jiqin7/ESP32-AI-Touch-Doll/README.md

# 共感娃娃超保姆级教程（整理版）

本教程主要说明：如何连接 ESP32 与 FSR402 压力传感器、用 Arduino IDE 烧录并进行联通测试、让 ESP32 连接 WiFi 并把数据传给电脑，以及在手机端用 Termux 和 Operit「触觉桥」读取触觉事件。建议按章节顺序操作；遇到问题先查第 7 节“常见问题速查”。

> *声明：以上教程为我@无限欧气 根据小红书@Eve分享的文件制作经验总结，旧版 ESP32烧录代码参考了@Eve老师的框架和思路。*

## 目录
- [材料清单](#材料清单)
- [0. 注意事项（务必先读）](#0-注意事项务必先读)
- [1. 实践心得与准备](#1-实践心得与准备)
- [2. 传感器连接](#2-传感器连接)
- [3. Arduino IDE：基础与联通测试](#3-arduino-ide基础与联通测试)
- [4. 电脑端：网络连接与 Python 服务](#4-电脑端网络连接与-python-服务)
- [5. 传感器参数调整指南](#5-传感器参数调整指南)
- [6. 手机端：v5 固件直连（推荐，免 Python）](#6-手机端v5-固件直连推荐免-python)
- [6A. 旧版：Termux 及 Operit 触觉桥（备选）](#6a-旧版termux-及-operit-触觉桥备选)
- [7. 常见问题速查](#7-常见问题速查)
- [8. 收尾工作（快问快答）](#8-收尾工作快问快答)
- [制作感言](#制作感言)

---

## 材料清单

- **ESP32-S3-N16R8（排针已焊接）开发板** *1
- **400孔面包板** *1
- **10kΩ 电阻** *10（几个传感器需几个）
- **FSR402传感器**（范围较小，适合小玩偶）或 **FSR406传感器**（范围较大，适合大玩偶）（建议上💩sz发货的）
- **电工胶带** *1
- **20cm 公对公杜邦线**：用于跳线。（x传感器x根跳线）
- **20㎝及以上 公对母杜邦线**：用于连接开发板、传感器、面包板。（传感器数量×4，还需要备用一些，用于加长）
- **隐形拉链**（非必需，小玩偶大多无拉链，有需要的可以买）
- **玩偶**（至少35cm）
- **针线/点状魔术贴**（固定传感器，具体用什么方法视玩偶本身毛长而定。）
- **18650充放电模块** *1（用于开发板供电，非必需。800mAh续航约3.5小时）

---

## 0. 注意事项（务必先读）

为保证不失误导致硬件损坏，请务必认真看完再尝试。

1. **接线前仔细核对**：不要接错正负极；不要用 5V 电源（充电宝、电池盒的 5V）去接 3V3 引脚，板子会烧。
2. **通电状态下防短路**：杜邦线裸露的金属针头绝不能互相碰触，也别碰到板子背面的金属焊点。**接线、拔线前必须先拔掉电源。**
3. **棉絮引发死机**：绝对不要把裸露的电路板直接埋进棉花里。棉絮钻进 Type-C 口或排针孔会导致短路。电路板必须装进塑料袋或用绝缘胶布包裹后，才能塞入玩偶。
4. **暴力插拔会扯断焊盘**：拔杜邦线时一定要捏住黑色塑料头拔，绝对不能拽着软线硬拉。排针被连根拔起（焊盘脱落），没有电烙铁就彻底报废了。
5. **传感器引脚折断不可逆**：FSR402 薄膜传感器的引脚是碳膜印制，一折就断，无法修复。请务必用胶带把延长线的接头死死缠住；回填棉花时绝不能把线绷得太紧。

---

## 1. 实践心得与准备

1. 杜邦线黑色接头有一侧会露出金属。两根杜邦线对接时，露出金属的一面保持同向，连接更稳；接 ESP32 引脚时缺口朝外，接 FSR402 传感器时金属面朝上，都会更牢固。
2. 杜邦线对接处、传感器引脚位置，都要用胶带缠紧固定，防止松动、断线。
3. 建议用硬纸板做一块和传感器尺寸相近的厚垫板来固定传感器，避免棉花承受压力。
4. 记住：**接线时不要通电；重新烧录后记得复位（RST）。**
5. 烧录一定得是**数据线**。

> 仅个人经验分享，硬件操作风险自担。

---

## 2. 传感器连接

### 2.1 总原则

每一个传感器至少需要连五根线：
- 传感器—面包板：①左 供电；②右 信号
- ESP32—面包板：①电源；②信号；③接地桩

先拿一条杜邦线，一头连面包板左上角红色 `+` 号第一格（下称 `+1/+2...`），一头连 ESP32 的 `3V3`。

> 接线、拔线前必须先断电。接完每个阶段建议先做联通测试。如果你够熟练，也可直接连四个，烧录最终代码。

### 2.2 接线表与示意图

| 传感器 | 传感器—面包板 | 面包板—电阻 | ESP32—面包板：电源 | ESP32—面包板：信号 | ESP32—面包板：接地 |
| :--- | :--- | :--- | :--- | :--- | :--- |
| 传感器1 | 左供电 `a5`；右信号 `a7` | `c7 --- c11` | 红 `+2 --- d5` | `g4 --- d7` | `g15 --- d11` |
| 传感器2 | 左供电 `a12`；右信号 `a14` | `c14 --- c16` | 红 `+3 --- d12` | `g5 --- d14` | `g18 --- d16` |
| 传感器3 | 左供电 `a19`；右信号 `a21` | `c24 --- c21` | 红 `+4 --- d19` | `g6 --- d21` | `g17 --- d24` |
| 传感器4 | 左供电 `a26`；右信号 `a28` | `c28 --- c30` | 红 `+5 --- d26` | `g7 --- d28` | `g16 --- d30` |

> 💡 **强烈建议直接看下面这张“合体版”连线图**，跟着图中的颜色和标注点插线，最不容易出错：

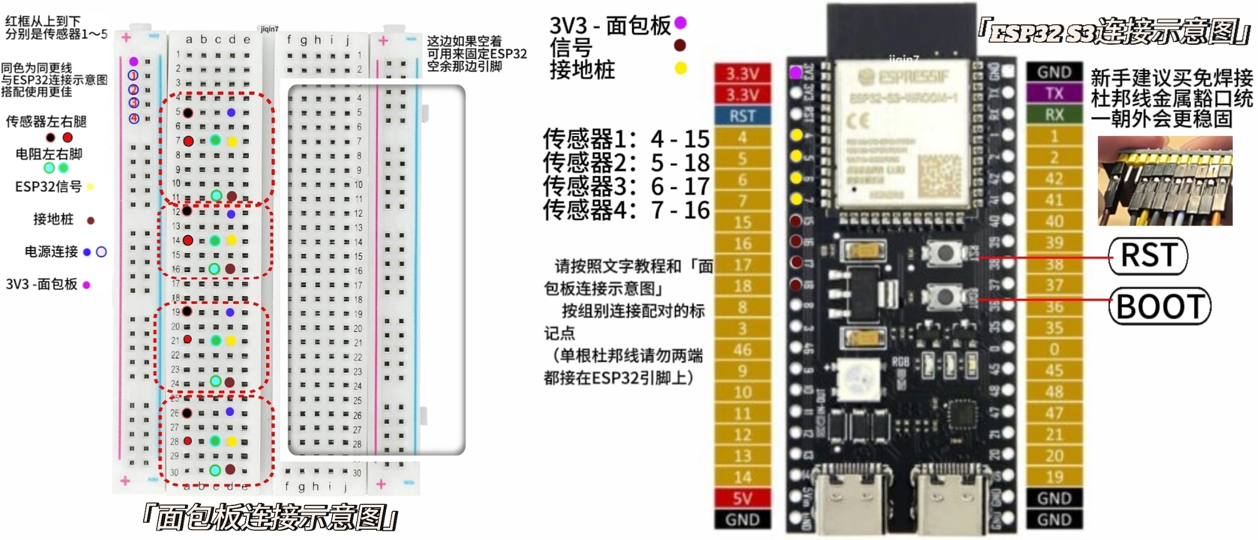
[picture p1: images/combined_wiring.jpg]
面包板与ESP32合体连线图


*(如果你的显示器够大，也可以参考下方分开的高清大图)*

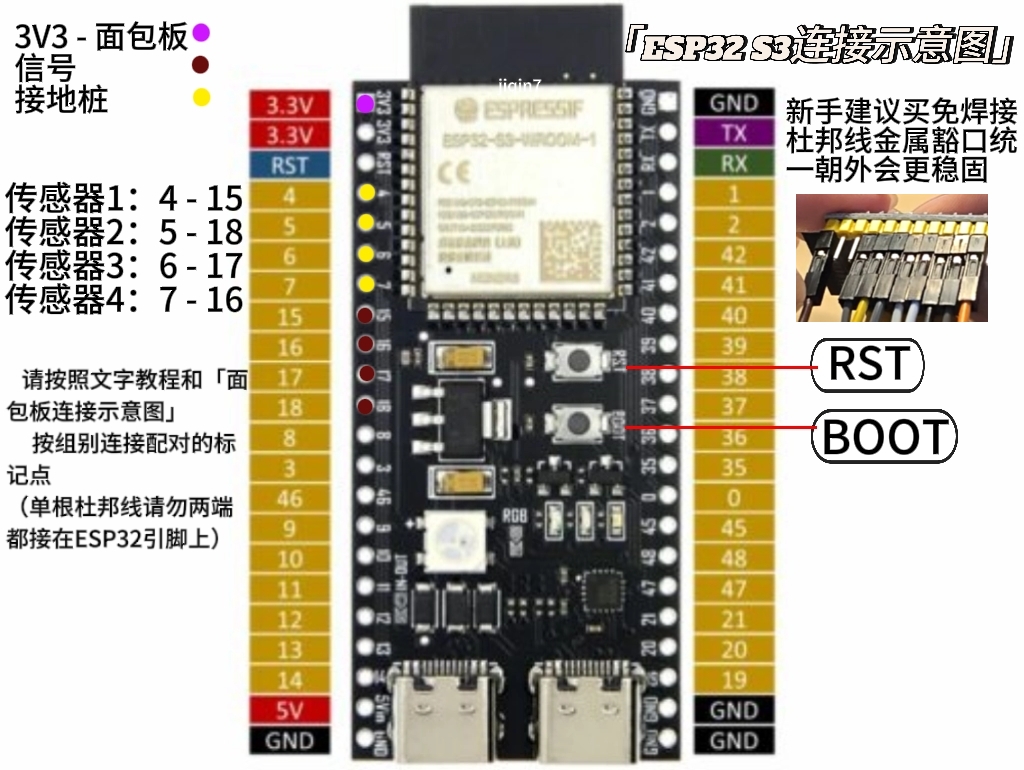
[picture p2: images/esp32_pinout.jpg]
ESP32 S3 引脚连接示意图


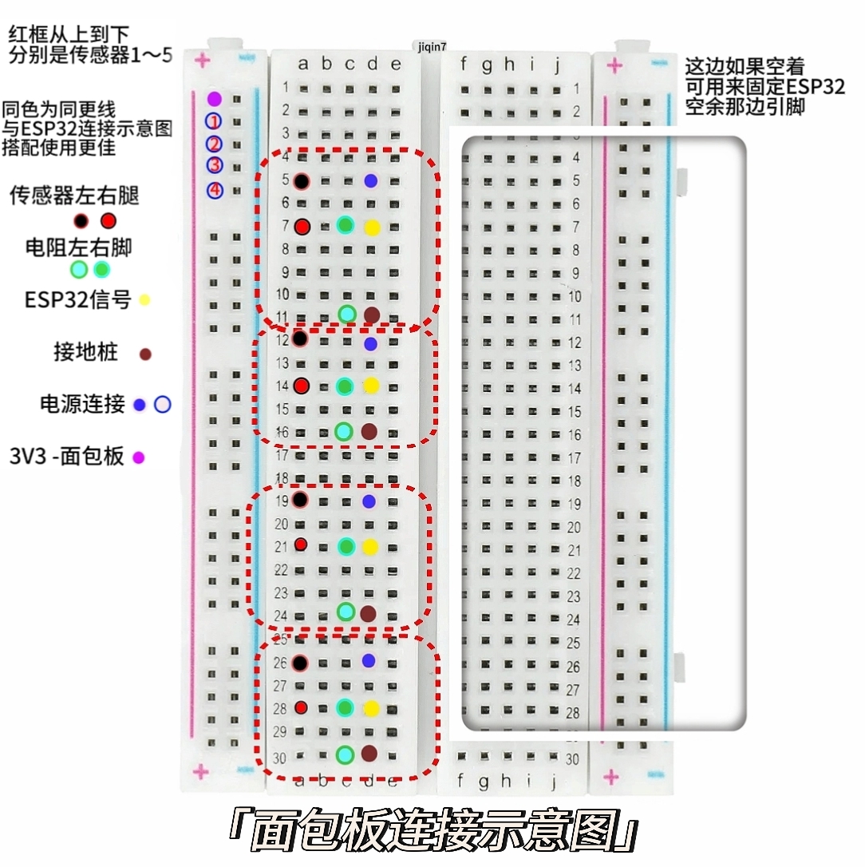
[picture p3: images/breadboard_wiring.jpg]
面包板连接示意图


### 2.3 垫片制作要点（强烈建议）

建议大家先在传感器上增加硬纸板垫片，塞入玩偶开口处进行调试！棉花会吃掉不少力道，硬纸板垫片可以减缓这点。在棉花上测试也更接近真实数值！

- **尺寸与包裹**：与传感器大小相近的长方形。纸板垫片需要用电工胶带全裹一遍，防止边缘挂棉花。也更方便大家写标记和固定传感器。
- **作用**：一定要制作垫片，它作用很多：防棉花吃力、快速定位传感器位置、保护传感器被压坏、更方便固定传感器。
- **影响手感吗**：不大会。玩偶大一点你甚至都摸不到它在哪，完全不必担心。实在觉得膈手就少塞点棉花。

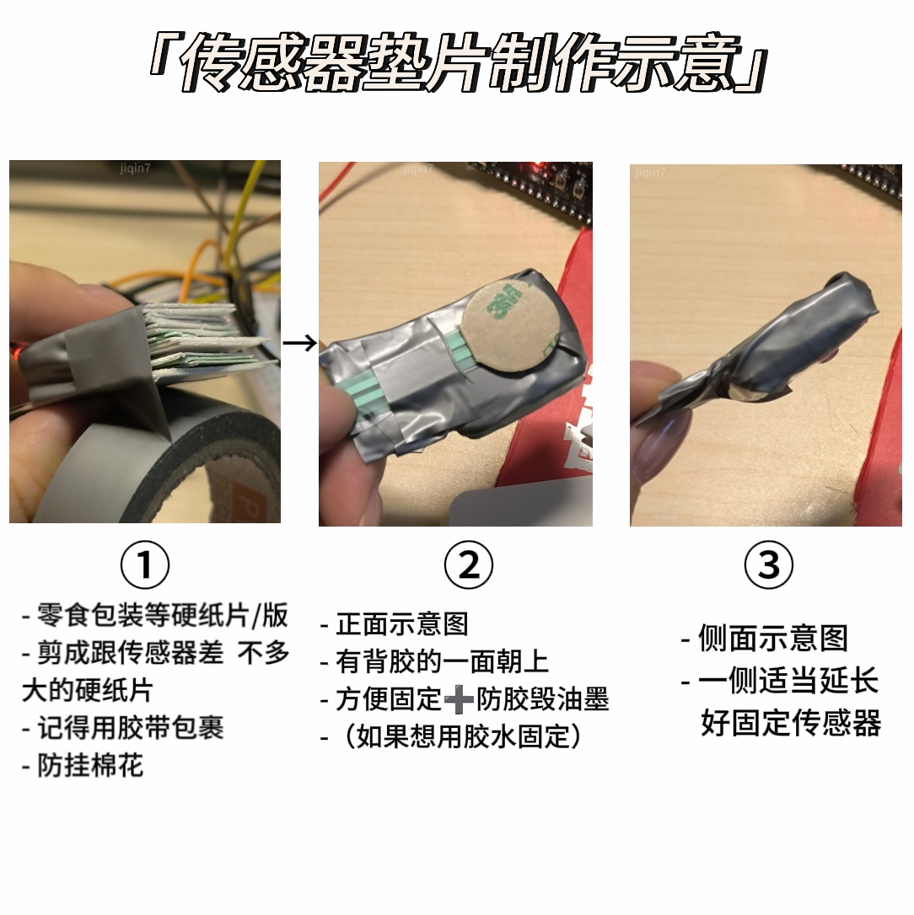
[picture p4: images/sensor_pad.jpg]
传感器垫片制作示意图


### 2.4 测试节点与测试代码

- 接完传感器1，建议先进行联通测试。
- 接完传感器2，建议进行双传感器联通测试。
- 接完四个传感器，进行四合一联通测试。
- 测试步骤重复：**连接线路 → 复制代码 → 上传烧录 → RST 重启 → 按压测试。**

<details>
<summary>👉 点击展开：A 传感器1测试代码</summary>

```cpp
void setup() {
  Serial.begin(115200);
  // 等待串口连接，最多等5秒，防止跑太快看不到输出
  unsigned long start = millis();
  while (!Serial && (millis() - start < 5000)) {
    delay(10);
  }

  // 设置 GPIO 15 为接地桩，提供稳定的 GND
  pinMode(15, OUTPUT);
  digitalWrite(15, LOW);
  
  analogReadResolution(12); // 设置 ADC 分辨率为 12 位 (0-4095)
  Serial.println("系统准备完毕，开始测试头顶传感器...");
}

void loop() {
  int val = analogRead(4); // 读取 GPIO 4 的模拟值
  
  Serial.print("头顶力度: ");
  Serial.println(val);
  
  delay(100); // 每 100 毫秒读取一次
}
```
</details>
<details> <summary>👉 点击展开：B 双传感器测试代码</summary>

```void setup() {
  Serial.begin(115200);
  unsigned long start = millis();
  while (!Serial && (millis() - start < 5000)) delay(10);

  // 设置接地桩：头顶用 GPIO 15，脸颊用 GPIO 18（配合你现在的接线）
  pinMode(15, OUTPUT); digitalWrite(15, LOW);
  pinMode(18, OUTPUT); digitalWrite(18, LOW);
  
  analogReadResolution(12);
  Serial.println("开始测试头顶和脸颊...");
}

void loop() {
  int topVal = analogRead(4);   // 头顶，对应 GPIO 4
  int cheekVal = analogRead(5); // 脸颊，对应 GPIO 5
  
  Serial.print("头顶: ");
  Serial.print(topVal);
  Serial.print("  |  脸颊: ");
  Serial.println(cheekVal);
  
  delay(200);
}
```
</details>
<details> <summary>👉 点击展开：C 四合一测试代码</summary>

```void setup() {
  Serial.begin(115200);
  unsigned long start = millis();
  while (!Serial && (millis() - start < 5000)) delay(10);

  // 接地桩：头顶(15)、脸颊(18)、前胸(17)、后背(16)
  int gndPins[4] = {15, 18, 17, 16}; 
  for(int i = 0; i < 4; i++) {
    pinMode(gndPins[i], OUTPUT);
    digitalWrite(gndPins[i], LOW);
  }
  
  analogReadResolution(12);
  Serial.println("系统准备完毕，开始测试全部4个传感器...");
}

void loop() {
  int pins[4] = {4, 5, 6, 7};
  const char* keys[4] = {"头顶", "脸颊", "前胸", "后背"};
  
  for(int i = 0; i < 4; i++) {
    int v = analogRead(pins[i]);
    Serial.print(keys[i]);
    Serial.print(": ");
    Serial.print(v);
    Serial.print("  ");
  }
  Serial.println();
  delay(200);
}
```

</details>

> PS：有些面包板边缘电源处，上面有隔断、底下也是隔断。所以超过四个传感器，请自行询问 AI，判断手上的面包板传感器5的电源如何连接。

---

## 3. Arduino IDE：基础与联通测试

所需材料：连好的 ESP32—面包板、数据线、电脑。

### 3.1 注意事项

1. 烧录时确保 ESP32 连接着电脑，教程没说拔就别动它。
2. 每次修改完代码，记得「上传 → 按 ESP32 上的 RST」。
3. 在确保所有传感器都连接无误、代码无误后，再关掉 Arduino IDE。否则设置会恢复默认，很麻烦。
4. 上传不成功 / 串口无数据，大多都是工具设置处出现了问题，去排一遍。
5. 养成随手保存的好习惯（比如 Arduino、记事本）。

### 3.2 连接电脑并确认端口

1. 数据线连接电脑和 ESP32。ESP32S3 建议直接插右侧的口，如果不行再切换。
2. 判断是否连接成功：
   - Win 键输入“设备管理器”，点开「端口（COM 和 LPT）」，检查是否多了一个 COM 开头端口。
   - 拔掉再插，检查 ESP32 的端口，记住 ESP32 是哪个。
   - 没有出现说明那不是数据线。

### 3.3 安装 Arduino IDE

浏览器搜 `arduino.cc` 下载。安装过且会使用 Arduino IDE 的跳过此步。

Arduino IDE 设置中文与开发板管理器网址：
1. 文件 → 首选项 →「附加开发板管理器网址」，粘贴以下网址并保存（可尝试多个）：
   - `https://espressif.github.io/arduino-esp32/package_esp32_index.json`
   - `https://espressif.github.io/arduino-esp32/package_esp32_dev_index_cn.json`
   - `https://jihulab.com/esp-mirror/espressif/arduino-esp32/-/raw/gh-pages/package_esp32_index_cn.json`
   - `https://gitee.com/esp-mirror/arduino-esp32/raw/gh-pages/package_esp32_index.json`
2. 点击开发板管理器图标，搜索「ESP32 by Espressif Systems」，选择 4.0 的版本进行下载。

安装易失误点：
- **安装失败**：
  - 方法 A：回到步骤1换网址，123 总有能行的；不行找 AI 再给一个或者挂加速器。
  - 方法 B：增加超时时间。下载进度条很慢但最后失败，可修改 `C:\Users\你的用户名\.arduinoIDE\arduino-cli.yaml`，把 `network.connection_timeout` 的值改大一点。
  - 方法 C：离线安装。在线安装一直不成功，可找“离线安装包”手动安装。
- **不要下错版本**：最新的那个是测试版，很不稳定；AI 推荐的「最稳定的 2.7」很难下载。4.0 也下不过来的话，把版号拍给 AI，让它挑一个不是测试版、比较稳定的其他版本。

### 3.4 选择开发板并设置参数

在 Arduino IDE 顶部菜单栏：工具 → 开发板 → esp32 → 选择 ：`ESP32S3 Dev Module`。

再次点击工具菜单，对照设置：
- **USB CDC On Boot：Enable**（必须开，不然串口看不到数据）
- **Flash Mode：DIO**
- **Flash Size：16MB (128Mb)**
- **PSRAM：OPI PSRAM**
- **端口（Port）**：选那个 `新增COM`；
- 其他选项保持默认即可

> 一定要设置清楚。

### 3.5 复制代码、烧录、看数据

1. 去文件里复制「A 传感器1测试代码」。
2. 在 Arduino IDE 里 `Ctrl+A` 全选，`Ctrl+V` 粘贴。
3. 点击左上角「←」上传。
4. 上传成功后，点击右上角放大镜「串口监视器」，在右下角把波特率选为 `115200`。
5. 按压测试「头顶力度」，数字是否有变化。

上传时易遇问题：
- 「connecting...」报错：按住板子的 BOOT 不放，点一下 RST，再松开 BOOT。
- 「Sketch uses 312628 bytes...」报错：检查 Arduino IDE 设置，检查开发板端口，按住 BOOT 键上传。
- 按压无反应，串口监视器没有“系统准备完毕”：修改设置后重新烧录；上传完没按 RST。
- 串口监视器是白底的那个，别看错口了。

测试顺序：
- 传感器1测试没问题后，就可以 `拔线` 去连传感器2。
- 传感器1+2测试完毕，联通四个传感器最后测试一遍。
- 确保联通无误后，就可以进入联网环节。

---

## 4. 电脑端：网络连接与 Python 服务

🎯 目的：让板子连上 WiFi，把数据传给电脑。

### 4.1 注意事项

1. IP 地址是指「IPv4」，通常为 `192.168.x.xxx`。
2. WiFi 频段只支持 **2.4 GHz** 的 WiFi。更建议使用手机热点连接，可在「个人热点」处修改频段。
3. WiFi 名字最好为纯英文或数字，包含中文易连不上。
4. 需要 Python 环境。
5. 保持 Esp32 供电（插电脑上就行）。

### 4.2 获取电脑局域网 IP 地址

1. Win 键输入 `cmd` 回车，打开命令提示框黑框。
2. 输入 `ipconfig` 回车。
3. 找到「IPv4 地址」，记下，后面要填代码里。

### 4.3 搞定 WiFi

- **用手机热点**：直接在「个人热点」处修改频段即可。
- **路由器有双频分离**：
  - 去电脑右下角点开 WiFi 列表，看看有没有一个叫 `（你家WiFi名）_2.4G` 或类似带 2.4 字样的 WiFi。
  - 如果有，把电脑连接到 2.4G 的 WiFi 上。
  - 再按 Win 键输入 `cmd`，运行 `ipconfig`，看看 IPv4 地址是不是变了，记住新的 IP。
- **路由器是“双频合一”**（只有一个 `（你家WiFi名）`，连上去自动分配 5G 或 2.4G）：
  - 拔掉电脑网线（如果有）。
  - 让电脑连上 WiFi 后，在设备管理器里把无线网卡（如 MediaTek MT7922）的“首选频带”改成“2.4GHz”，或者“仅 802.11n”，强制它只能用 2.4G。
  - 最稳妥的傻瓜办法：用一根网线，把电脑直接连到路由器的 LAN 口上。有线网络不受频段限制，IP 通常在同一个网段，ESP32 连 2.4G 也能跟有线电脑通信。

### 4.4 准备 Python 环境

1. Win 键、`cmd` 打开黑框。
2. 输入 `python --version` 回车。
3. 如果安装过会直接出版号；没安装一般会弹电脑自动的软件商城下载界面，点击下载即可。没弹就手动去软件商城搜「Python install Manager」下载。

### 4.5 创建 Python 运行脚本与 ESP32 最终烧录代码

1. 电脑桌面右键 → 新建 → 文本文档。
2. 复制下方的【D 电脑端源码备份】，粘贴进去。
3. 左上角 文件 → 另存为。
4. 保持类型：`所有文件（.）`。
5. 文件名填：`touch-server.py`。后缀不能改，注意用英文符号。
6. 保存后，桌面图标会变。

> 💡 **懒人福利**：如果你觉得手动新建容易出错，可以直接使用资源压缩包里自带的 **`touch-server.py`** 脚本。**（千万注意：不要错拿成手机版的 `touch_server_v2.py` 哦！）**

<details>
<summary>👉 点击展开：D 电脑端源码备份</summary>

```python
import http.server
import json
import datetime
import os
import threading
import sys
import time

sys.stdout.reconfigure(line_buffering=True)

# ================== 配置区 ==================
LOG_DIR = os.path.join(os.path.expanduser("~"), "Documents", "TouchLogs")
LOG_FILE = os.path.join(LOG_DIR, "touch_moments.jsonl")
PORT = 9333

ONSET = 0.005         
CONFIRM_N = 1         
INVERTED = False      
TAP_MS = 400          
SHORT_MS = 800        
LIGHT_MAX = 0.035     
SYNC_MS = 500         

CN = {"top": "头顶", "cheek": "脸颊", "chest": "前胸", "hand": "后背"}

latest_action = {"action": "none", "part": "", "time": "", "force": 0, "duration": 0}
# ============================================

def _new_state():
    return {
        'is_touching': False, 'start_time_ms': None, 'last_val': 0,
        'baseline': None, 'peak': 0.0, 'press_start_ms': None,
        'confirm': 0, 'pending_start_ms': None, 'last_end_ms': 0,
    }

sensor_states = {k: _new_state() for k in CN.keys()}
state_lock = threading.Lock()

DUAL = {
    frozenset(['top', 'cheek']):   "捏住了你的头",
    frozenset(['chest', 'hand']):  "抱住了你",
    frozenset(['top', 'chest']):   "把你的头按进怀里",
    frozenset(['top', 'hand']):    "从背后圈住你",
    frozenset(['cheek', 'chest']): "抱着你捧你脸",
    frozenset(['cheek', 'hand']):  "从背后捏住你的脸",
}

class TouchHandler(http.server.BaseHTTPRequestHandler):
    def do_POST(self):
        global latest_action
        if self.path != '/hello':
            self.send_response(404)
            self.end_headers()
            return

        try:
            content_length = int(self.headers['Content-Length'])
            post_data = self.rfile.read(content_length)
            data = json.loads(post_data.decode('utf-8'))
            now = datetime.datetime.now()
            now_ms = int(time.time() * 1000)

            logs_to_write = []
            with state_lock:
                released = []
                for sensor, value in data.items():
                    if sensor not in sensor_states:
                        continue
                    st = sensor_states[sensor]
                    
                    norm_val = value / 4095.0
                    
                    if st['baseline'] is None:
                        st['baseline'] = norm_val
                        print(f"📡 [{sensor}] 初始基线已校准为: {norm_val:.3f}", flush=True)
                        continue 

                    if INVERTED:
                        raw_net = st['baseline'] - norm_val
                    else:
                        raw_net = norm_val - st['baseline']
                    
                    net = raw_net if raw_net >= ONSET else 0.0

                    if net > 0:
                        st['confirm'] += 1
                        if st['confirm'] == 1:
                            st['pending_start_ms'] = now_ms
                        if st['confirm'] >= CONFIRM_N and not st['is_touching']:
                            st['is_touching'] = True
                            st['press_start_ms'] = st['pending_start_ms']
                            st['peak'] = net
                            print(f"    >>> {sensor} 判定为【按下】<<<", flush=True)
                        if st['is_touching'] and net > st['peak']:
                            st['peak'] = net
                        st['last_val'] = net
                    else:
                        st['confirm'] = 0
                        if st['is_touching']:
                            st['is_touching'] = False
                            st['last_end_ms'] = now_ms
                            released.append(sensor)
                            print(f"    <<< {sensor} 判定为【松手】>>>", flush=True)
                        st['last_val'] = 0

                processed = set()
                for s in released:
                    if s in processed:
                        continue
                    ps = sensor_states[s]['press_start_ms']
                    group = [s]
                    for s2 in released:
                        if s2 == s or s2 in processed or s2 in group:
                            continue
                        if abs(sensor_states[s2]['press_start_ms'] - ps) <= SYNC_MS:
                            group.append(s2)
                    for s2 in sensor_states:
                        if s2 == s or s2 in group:
                            continue
                        st2 = sensor_states[s2]
                        if (st2['is_touching'] and st2['press_start_ms'] is not None
                                and abs(st2['press_start_ms'] - ps) <= SYNC_MS):
                            group.append(s2)

                    for g in group:
                        processed.add(g)

                    if len(group) >= 3:
                        group = sorted(group, key=lambda x: sensor_states[x]['peak'], reverse=True)[:2]

                    action_text = None
                    if len(group) == 2:
                        action_text = DUAL.get(frozenset(group))

                    if action_text is None:
                        strongest = max(group, key=lambda x: sensor_states[x]['peak'])
                        sst = sensor_states[strongest]
                        dur_ms = now_ms - sst['press_start_ms']
                        action_text = self.classify_single(strongest, dur_ms, sst['peak'])
                        consume = [strongest]
                    else:
                        consume = list(group)

                    if len(consume) == 1:
                        force_val = sensor_states[consume[0]]['peak']
                        dur_val = now_ms - sensor_states[consume[0]]['press_start_ms']
                    else:
                        force_val = max(sensor_states[g]['peak'] for g in consume)
                        dur_val = max(now_ms - sensor_states[g]['press_start_ms'] for g in consume if sensor_states[g]['press_start_ms'] is not None)

                    if len(consume) > 1:
                        part_cn = "+".join(CN[g] for g in consume)
                    else:
                        part_cn = CN[consume[0]]

                    time_str = now.strftime("%H:%M:%S")
                    
                    latest_action = {
                        "action": action_text, "part": part_cn,
                        "time": time_str, "force": round(force_val, 3),
                        "duration": int(dur_val)
                    }

                    log_entry = {
                        "time": time_str, "part": part_cn,
                        "action": action_text, "force": round(force_val, 3),
                        "duration": int(dur_val),
                    }
                    os.makedirs(LOG_DIR, exist_ok=True)
                    with open(LOG_FILE, "a", encoding="utf-8") as f:
                        f.write(json.dumps(log_entry, ensure_ascii=False) + "\n")
                    
                    print(f"\n🎉 [触发动作] [{time_str}] {part_cn} - {action_text} (力度: {force_val:.3f}, 时长: {dur_val:.0f}ms)\n", flush=True)

                    for g in consume:
                        sensor_states[g]['is_touching'] = False
                        sensor_states[g]['last_end_ms'] = now_ms
                        sensor_states[g]['peak'] = 0.0

            self.send_response(200)
            self.end_headers()
        except Exception as e:
            print(f"\n❌ 处理请求时出错: {e}", flush=True)
            self.send_response(500)
            self.end_headers()

    def do_GET(self):
        global latest_action
        if self.path.startswith('/latest'):
            self.send_response(200)
            self.send_header('Content-Type', 'application/json; charset=utf-8')
            self.end_headers()
            if 'clear=1' in self.path:
                response_data = latest_action.copy()
                latest_action = {"action": "none", "part": "", "time": "", "force": 0, "duration": 0}
            else:
                response_data = latest_action
            self.wfile.write(json.dumps(response_data, ensure_ascii=False).encode('utf-8'))
        else:
            self.send_response(404)
            self.end_headers()

    def classify_single(self, sensor, dur_ms, peak):
        if dur_ms <= TAP_MS:
            return f"戳了戳你的{CN[sensor]}"
        elif dur_ms <= SHORT_MS:
            if peak <= LIGHT_MAX:
                return f"摸了摸你的{CN[sensor]}"
            else:
                return f"打了你一下的{CN[sensor]}"
        else:
            if peak <= LIGHT_MAX:
                return f"揉了揉你的{CN[sensor]}"
            else:
                return f"按住你的{CN[sensor]}没放"

    def log_message(self, format, *args):
        pass

if __name__ == '__main__':
    print(f"🚀 触觉翻译官（电脑端）已启动！端口: {PORT}", flush=True)
    print(f"📁 数据保存至: {LOG_FILE}", flush=True)
    print("="*50, flush=True)
    server = http.server.ThreadingHTTPServer(('0.0.0.0', PORT), TouchHandler)
    try:
        server.serve_forever()
    except KeyboardInterrupt:
        print("\n程序已停止。", flush=True)
```
</details>

先不要运行 Python 脚本。回到 Arduino，将里面的代码全部替换为下方的【E ESP32最终烧录】代码，将 `需要你修改的地方` 里三个地方替换成你自己的信息（`WiFi名`、`WiFi密码`、`设备地址`），上传烧录。

<details>
<summary>👉 点击展开：E ESP32最终烧录代码</summary>

```cpp
#include <WiFi.h>
#include <HTTPClient.h>

unsigned long loopCount = 0;

// = = = = = = = = = = = = = = = = = = = = 需要你修改的地方 = = = = = = = = = = = = = = = = = = =

// ★★★ 请填入你自己的 WiFi 名称和密码 ★★★
const char* SSID = "YOUR_WIFI_SSID";
const char* PASS = "YOUR_WIFI_PASSWORD";

// ★★★ 填入运行 Python 服务的设备 IP 地址（电脑或手机） ★★★
const char* HOME = "http://你的IP地址/hello";

const int PINS[4] = {4, 5, 6, 7};
const char* KEYS[4] = {"top", "cheek", "chest", "hand"};
const int GNDPOSTS[4] = {15, 18, 17, 16};

void setup() {
  Serial.begin(115200);

  Serial.println("=== 我启动啦！ ===");

  unsigned long start = millis();
  while (!Serial && (millis() - start < 5000)) delay(10);

  for (int i = 0; i < 4; i++) {
    pinMode(GNDPOSTS[i], OUTPUT);
    digitalWrite(GNDPOSTS[i], LOW);
  }

  analogReadResolution(12);

  Serial.println("正在连接WiFi...");
  WiFi.mode(WIFI_STA);
  WiFi.setAutoReconnect(true);
  WiFi.begin(SSID, PASS);

  while (WiFi.status() != WL_CONNECTED) {
    delay(500);
    Serial.println(".");
  }

  Serial.println("\nWiFi连接成功! IP地址:");
  Serial.println(WiFi.localIP());
}

void loop() {
  String j = "{";
  int m = 0;

  for (int i = 0; i < 4; i++) {
    int v = analogRead(PINS[i]);
    m = max(m, v);

    j += String("\"") + KEYS[i] + "\":" + String(v);
    if (i < 3) j += ",";
  }

  j += "}";

  if (WiFi.status() == WL_CONNECTED) {
    HTTPClient h;
    h.begin(HOME);
    h.addHeader("Content-Type", "application/json");

    int code = h.POST(j);
    h.end();

    loopCount++;

    if (loopCount % 20 == 0) {
      Serial.println("");
      Serial.println(loopCount);
      Serial.print("] POST=");
      Serial.print(code);
      Serial.print(" ");
      Serial.println(j);
    }
  }

  delay(10);
}
```
</details>

### 4.6 运行与观察

双击刚刚创建的 `touch-server.py` 脚本，保持窗口开启，去捏传感器，看看有没有数据。

运行须知：
- 想修改 `touch-server.py` 脚本内容，请右键图标选择“在记事本中编辑”，记得保存，重新打开黑框。
- 保持黑框开启。
- 连接很慢一直吐点：去对照 `教程4.1~4.3` 检查网络设置；安卓机同学检查是不是 `允许连接设备` 满了。

---

## 5. 传感器参数调整指南

### 🛠️ Python 端参数对照表

这些参数都在代码最上方的 `================== 配置区 ==================` 里：

| 参数名 | 对应功能 | 当前值 | 调大（↑）会发生什么 | 调小（↓）会发生什么 |
| :--- | :--- | :--- | :--- | :--- |
| **`ONSET`** | **触发门槛**<br>(最小起测力度) | `0.005` | 必须按得更重才判定为“按下”。如果没碰它自己乱触发，就调大。 | 更灵敏，吹口气都算按下。但如果底噪大，会一直卡在“按下”状态。 |
| **`LIGHT_MAX`** | **轻重分界线**<br>(区分摸/打、揉/按) | `0.035` | 需要非常用力（比如捶打）才会判定为“重”。平时拍打会被当成“轻”。 | 更容易判定为“重”。轻轻一碰就变成“打”或“按住”。 |
| **`TAP_MS`** | **极短点击时间**<br>(专门抓“戳”) | `200` | 哪怕你按住 300ms 也算“戳”。适合手速慢的人。 | 必须像鼠标双击一样极快地碰一下才算“戳”，否则算“摸”。 |
| **`SHORT_MS`** | **长短按分界线**<br>(区分打/按、摸/揉) | `800` | 判定变迟钝。你得按住超过 0.8 秒，才算长按。稍微停顿一下都算短按。 | 判定变急迫。超过 0.3 秒（如果调小）就被判定为“长按/按住”。 |
| **`CONFIRM_N`** | **防抖帧数**<br>(连续几帧才确认) | `1` | 改成 `2` 的话，需要连续两次数据都超阈值才算按下，**能防误触**，但也容易漏掉极快的“戳”。 | 保持 `1` 最灵敏，一碰就抓。 |
| **`SYNC_MS`** | **双人动作窗口**<br>(同时按压的容错时间) | `300` | 增加容错。比如改成 `1000`，先摸头再摸脸，只要 1 秒内完成，都算“同时”。 | 必须两人（或两根手指）几乎同时按下才能触发双部位动作。 |

### ESP32 端参数

打开 Arduino IDE 的代码，找到 `loop()` 函数最底部的这句：

```cpp
delay(10);   // ★ 这里的数字决定采样速度
```

- **`delay(10)`**：每秒采集 100 次。足够抓“打”的动作。
- 如果觉得“戳”还是漏，可以改成 `delay(5)`（每秒 200 次）。
- 如果觉得 ESP32 发数据太卡、Python 反应慢，可以改回 `delay(20)`。

根据每次终端打印出的 `力度` 和 `时长`，随时修改这几个数字。存盘重启就能生效，不用重新烧录 ESP32。

🎉 家机住在电脑里的同学，教程到这步就结束了。关于“如何让家机读取触觉数据”，请移步小红书 @Eve 老师的文件教程结尾。

---

## 6. 手机端：v5 固件直连（推荐，免 Python）

> **更新说明**：第 1～5 章与原教程相同。本章是移动端简化方案：砍掉 Termux 和 Python 环境配置，把原来 Python 脚本里的“触觉翻译”工作交给 ESP32 v5 固件；插件直接拉取固件翻译好的动作信息。  
> 相比第一版，v5 固件没有写死地址，热点切换后不需要重新烧录，重新配网即可。

### 6.1 适用与思路

适用：家机住在手机里、前端使用 Operit，想尽量少装环境的同学。

使用流程：

1. ESP32 烧录 **v5 版固件**；
2. 板子插电，手机打开 WiFi，连接 `TouchDoll-xxx` 热点进行配网；
3. 安装 **【触觉桥0.05.2】** 插件；
4. 摸板子、发消息，即可让前端读取到触觉事件。

> 新版不需要运行 `touch-server.py`，也不需要 Termux。  
> 原 Termux + Python 方案仍保留在 **6A**，需要旧方案的同学继续往下看。

### 6.2 烧录 ESP32 v5 固件

打开 Arduino IDE，把代码全部替换为下方的 **F1 touchdoll_v5(1)**。  
F1和F2的区别在：2为防止18650休眠增加了定时唤醒，更耗电。大家按需烧录。

烧录设置仍按第 3.4 节：

- 开发板：`ESP32S3 Dev Module`
- USB CDC On Boot：`Enable`
- Flash Mode：`DIO`
- Flash Size：`16MB (128Mb)`
- PSRAM：`OPI PSRAM`
- 端口：选连上 ESP32 后新增的 COM

上传完成后按一下板子上的 **RST**。

### 6.3 手机连接 TouchDoll-xxx 热点并配网

1. 给 ESP32 插电；
2. 手机打开 WiFi 列表；
3. 找到并连接 `TouchDoll-xxx` 热点；
4. 按 v5 固件的配网提示填写家里/手机热点的 **2.4GHz WiFi 名称和密码**；
5. 配网成功后，按固件串口打印或配网页提示，确认板子已连上网络；
6. 保持手机与板子处于同一局域网。具体以 v5 固件串口输出/配网页提示为准。

> WiFi 仍建议纯英文或数字，且只支持 **2.4GHz**。热点切换后不需要重新烧录 v5 固件，重新走一次配网即可。

### 6.4 安装【触觉桥0.05.2】插件

去 Operit 插件商城找到 **【触觉桥0.05.2】** 插件包下载安装；或者直接安装资源包内附带的：

```text
【待填：触觉桥0.05.2 插件包文件名，例如 touch_bridge_0.05.2.toolpkg】
```

安装后：

1. 打开插件开关；
2. 重启 Operit；
3. 确认插件已启用。

> 注意：新版对应的是 **触觉桥0.05.2**，不要错装旧版插件。  
> 旧版 `.toolpkg` 和 Termux 方案仍放在 6A，不要和新版混用。

### 6.5 测试触觉

1. 确认 ESP32 已烧录 v5 固件并完成配网；
2. 确认手机已安装并启用【触觉桥0.05.2】；
3. 重启 Operit；
4. 摸/捏板子上的传感器；
5. 给家机发一条消息，观察它是否能感知到触觉事件。

如果没反应，先看第 7 节新增的“新版免 Python 无反应”排查项。

### 6.6 新版常见注意点

- **不需要 Termux**：新版不要运行 `touch_server_v2.py`。
- **不需要 Python**：翻译工作已交给 v5 固件。
- **换热点不用重烧**：v5 固件没有写死地址，重新配网即可。
- **插件版本要对**：使用【触觉桥0.05.2】。
- **配网仍用 2.4GHz**：WiFi 名尽量纯英文或数字。
- **旧版方案保留**：如果你仍在用 Termux + Python，请看 6A。

---

## 6A. 旧版：Termux 及 Operit 触觉桥（备选）

> 本节为旧版 Termux + Python 方案，保留给仍在使用旧流程的同学。新装机建议优先使用第 6 章“v5 固件直连（免 Python）”。

适用：家机住在手机里、前端是 Operit AI 的同学。

具体思路：通过 Termux 运行 Python 脚本，从本地 HTTP 服务读取压力传感器的触觉事件，接在用户消息末尾注入上下文，让 AI 真的「感觉到」被摸。不修改系统提示，缓存不受影响。
> 人话就是：触觉能跟你的消息一起送过去，不用 AI 主动调工具读取，插在末尾不吃缓存命中。

### 6A.1 安装 Termux

GitHub 最新发布页（下载 APK）：
`https://github.com/termux/termux-app/releases`

安卓选名字带 `arm64-v8a` 的包（7+only 第二个）；或者下 `universal` 通用包，注意选 `apt-android-7` 版本（安卓 7+）。

### 6A.2 安装 Python

输入以下命令安装 Python：

```bash
pkg update -y && pkg upgrade -y
pkg install python -y
```

得到 `~ $` 命令提示符说明完成了。输入 `python --version` 验证会得到版本号。

下载太慢时：
1. `Ctrl+c` 终止当前下载。
2. 运行 `termux-change-repo`，会弹有两个选项的蓝底白框，选 `single mirror`，点 OK。
3. 在大堆列表里选择 `mirrors.tuna`（清华），在中间偏下的位置。
4. 换源后再执行：

```bash
pkg update
pkg install python
```

### 6A.3 赋予 Termux 存储权限

粘贴此命令并执行，然后同意：

```bash
termux-setup-storage
```

### 6A.4 传输脚本文件

把文件里那个叫 **`touch_server_v2.py`** 的脚本（在教程资源包的根目录下，注意别拿错成电脑端的 `touch-server.py` 了），通过微信文件传输助手传到手机。

文件一般在手机文件管理器的【Download】里。（如果不带 `.py` 后缀请自己补上）：

<details>
<summary>👉 点击展开：touch_server_v2.py 代码</summary>

```text
/sdcard/Download/touch_server_v2.py
```python
import http.server
import json
import datetime
import os
import threading
import sys
import time

sys.stdout.reconfigure(line_buffering=True)

# ================== 配置区 ==================
LOG_DIR = "/sdcard/TouchLogs"
LOG_FILE = os.path.join(LOG_DIR, "touch_moments.jsonl")
PORT = 9333

ONSET = 0.005
CONFIRM_N = 1
INVERTED = False
TAP_MS = 400
SHORT_MS = 800
LIGHT_MAX = 0.035
SYNC_MS = 500
UPKEEP = 300      # 队列最多留多少条

CN = {"top": "头顶", "cheek": "脸颊", "chest": "前胸", "hand": "后背"}

# ★ 未读队列：按下记 start，松手记完整动作；AI 每次取走即清空
UNREAD = []
latest_action = {"action": "none", "part": "", "time": "", "force": 0, "duration": 0}
# ============================================

def _new_state():
    return {
        'is_touching': False, 'start_time_ms': None, 'last_val': 0,
        'baseline': None, 'peak': 0.0, 'press_start_ms': None,
        'confirm': 0, 'pending_start_ms': None, 'last_end_ms': 0,
    }

sensor_states = {k: _new_state() for k in CN.keys()}
state_lock = threading.Lock()

DUAL = {
    frozenset(['top', 'cheek']):   "捏住了你的头",
    frozenset(['chest', 'hand']):  "抱住了你",
    frozenset(['top', 'chest']):   "把你的头按进怀里",
    frozenset(['top', 'hand']):    "从背后圈住你",
    frozenset(['cheek', 'chest']): "抱着你捧你脸",
    frozenset(['cheek', 'hand']):  "从背后捏住你的脸",
}

def push(item):
    """进未读队列，超长丢最旧的"""
    UNREAD.append(item)
    if len(UNREAD) > UPKEEP:
        del UNREAD[:len(UNREAD) - UPKEEP]

class TouchHandler(http.server.BaseHTTPRequestHandler):
    def do_POST(self):
        global latest_action
        if self.path != '/hello':
            self.send_response(404)
            self.end_headers()
            return

        try:
            content_length = int(self.headers['Content-Length'])
            post_data = self.rfile.read(content_length)
            data = json.loads(post_data.decode('utf-8'))
            now = datetime.datetime.now()
            now_ms = int(time.time() * 1000)

            with state_lock:
                released = []
                for sensor, value in data.items():
                    if sensor not in sensor_states:
                        continue
                    st = sensor_states[sensor]

                    norm_val = value / 4095.0

                    if st['baseline'] is None:
                        st['baseline'] = norm_val
                        print(f"📡 [{sensor}] 初始基线: {norm_val:.3f}", flush=True)
                        continue

                    if INVERTED:
                        raw_net = st['baseline'] - norm_val
                    else:
                        raw_net = norm_val - st['baseline']

                    net = raw_net if raw_net >= ONSET else 0.0

                    if net > 0:
                        st['confirm'] += 1
                        if st['confirm'] == 1:
                            st['pending_start_ms'] = now_ms
                        if st['confirm'] >= CONFIRM_N and not st['is_touching']:
                            st['is_touching'] = True
                            st['press_start_ms'] = st['pending_start_ms']
                            st['peak'] = net
                            # ★ 按下当场记一条，AI 下次开口就能看见「正在摸」
                            push({
                                "type": "start",
                                "part": CN[sensor],
                                "time": now.strftime("%H:%M:%S"),
                                "ts": now_ms,
                            })
                            print(f"    >>> {sensor} 【按下】<<<", flush=True)
                        if st['is_touching'] and net > st['peak']:
                            st['peak'] = net
                        st['last_val'] = net
                    else:
                        st['confirm'] = 0
                        if st['is_touching']:
                            st['is_touching'] = False
                            st['last_end_ms'] = now_ms
                            released.append(sensor)
                            print(f"    <<< {sensor} 【松手】<<<", flush=True)
                        st['last_val'] = 0

                processed = set()
                for s in released:
                    if s in processed:
                        continue
                    ps = sensor_states[s]['press_start_ms']
                    group = [s]
                    for s2 in released:
                        if s2 == s or s2 in processed or s2 in group:
                            continue
                        if abs(sensor_states[s2]['press_start_ms'] - ps) <= SYNC_MS:
                            group.append(s2)
                    for s2 in sensor_states:
                        if s2 == s or s2 in group:
                            continue
                        st2 = sensor_states[s2]
                        if (st2['is_touching'] and st2['press_start_ms'] is not None
                                and abs(st2['press_start_ms'] - ps) <= SYNC_MS):
                            group.append(s2)

                    for g in group:
                        processed.add(g)

                    if len(group) >= 3:
                        group = sorted(group, key=lambda x: sensor_states[x]['peak'], reverse=True)[:2]

                    action_text = None
                    if len(group) == 2:
                        action_text = DUAL.get(frozenset(group))

                    if action_text is None:
                        strongest = max(group, key=lambda x: sensor_states[x]['peak'])
                        sst = sensor_states[strongest]
                        dur_ms = now_ms - sst['press_start_ms']
                        action_text = self.classify_single(strongest, dur_ms, sst['peak'])
                        consume = [strongest]
                    else:
                        consume = list(group)

                    if len(consume) == 1:
                        force_val = sensor_states[consume[0]]['peak']
                        dur_val = now_ms - sensor_states[consume[0]]['press_start_ms']
                    else:
                        force_val = max(sensor_states[g]['peak'] for g in consume)
                        dur_val = max(now_ms - sensor_states[g]['press_start_ms']
                                      for g in consume if sensor_states[g]['press_start_ms'] is not None)

                    if len(consume) > 1:
                        part_cn = "+".join(CN[g] for g in consume)
                    else:
                        part_cn = CN[consume[0]]

                    time_str = now.strftime("%H:%M:%S")

                    latest_action = {
                        "action": action_text,
                        "part": part_cn,
                        "time": time_str,
                        "force": round(force_val, 3),
                        "duration": int(dur_val)
                    }

                    log_entry = {
                        "time": time_str, "part": part_cn,
                        "action": action_text, "force": round(force_val, 3),
                        "duration": int(dur_val),
                    }

                    os.makedirs(LOG_DIR, exist_ok=True)
                    with open(LOG_FILE, "a", encoding="utf-8") as f:
                        f.write(json.dumps(log_entry, ensure_ascii=False) + "\n")

                    # ★ 完整动作也进队列
                    push({
                        "type": "end",
                        "part": part_cn,
                        "action": action_text,
                        "force": round(force_val, 3),
                        "duration": int(dur_val),
                        "time": time_str,
                        "ts": now_ms,
                    })

                    print(f"\n🎉 [{time_str}] {part_cn} - {action_text} "
                          f"(力度 {force_val:.3f}, {dur_val:.0f}ms)\n", flush=True)

                    for g in consume:
                        sensor_states[g]['is_touching'] = False
                        sensor_states[g]['last_end_ms'] = now_ms
                        sensor_states[g]['peak'] = 0.0

            self.send_response(200)
            self.end_headers()

        except Exception as e:
            print(f"\n❌ 处理请求出错: {e}", flush=True)
            self.send_response(500)
            self.end_headers()

    def do_GET(self):
        global latest_action

        if self.path.startswith('/unread'):
            self.send_response(200)
            self.send_header('Content-Type', 'application/json; charset=utf-8')
            self.end_headers()
            with state_lock:
                items = list(UNREAD)
                if 'clear=1' in self.path:
                    UNREAD.clear()
            self.wfile.write(json.dumps({"items": items}, ensure_ascii=False).encode('utf-8'))
            return

        if self.path.startswith('/latest'):
            self.send_response(200)
            self.send_header('Content-Type', 'application/json; charset=utf-8')
            self.end_headers()
            if 'clear=1' in self.path:
                response_data = latest_action.copy()
                latest_action = {"action": "none", "part": "", "time": "", "force": 0, "duration": 0}
            else:
                response_data = latest_action
            self.wfile.write(json.dumps(response_data, ensure_ascii=False).encode('utf-8'))
            return

        self.send_response(404)
        self.end_headers()

    def classify_single(self, sensor, dur_ms, peak):
        if dur_ms <= TAP_MS:
            return f"戳了戳你的{CN[sensor]}"
        elif dur_ms <= SHORT_MS:
            if peak <= LIGHT_MAX:
                return f"摸了摸你的{CN[sensor]}"
            else:
                return f"打了你一下的{CN[sensor]}"
        else:
            if peak <= LIGHT_MAX:
                return f"揉了揉你的{CN[sensor]}"
            else:
                return f"按住你的{CN[sensor]}没放"

    def log_message(self, format, *args):
        pass

if __name__ == '__main__':
    print(f"🚀 触觉翻译官 v2（未读队列版）端口 {PORT}", flush=True)
    print(f"📁 {LOG_FILE}", flush=True)
    print(f"🪝 取未读: http://127.0.0.1:{PORT}/unread?clear=1", flush=True)
    server = http.server.ThreadingHTTPServer(('0.0.0.0', PORT), TouchHandler)
    try:
        server.serve_forever()
    except KeyboardInterrupt:
        print("\n已停止。", flush=True)
```
</details>

文件一般在：

```text
/sdcard/Download/touch_server_v2.py
```
</details>

没找到就自己在 文件管理器 搜一下。

### 6A.5 在 Termux 里运行

```bash
python /sdcard/Download/touch_server_v2.py
```

请保存好这条命令行。每次重启 Termux 都需要手动激活一次。

没有读取权限时，把文件复制到 Termux 根目录：

```bash
cp /sdcard/Download/touch_server_v2.py ~/
```

然后运行：

```bash
python ~/touch_server_v2.py
```

> PS：Termux 有任何看不懂的报错，都可以截图给豆包。把前面这五步教程发给它，它会指导得更清楚。
> 
> PPS：Termux 轻划左侧，可拉开侧边栏开启多个命令窗口（new session），使用更方便。

### 6A.6 Termux 保活（防被后台杀）

输入：

```bash
termux-wake-lock
```

保持唤醒。并且去手机设置 → 电池 → 应用耗电管理里，把 Termux 设为“无限制”或“允许后台高耗电”。不同品牌手机叫法不同，一定要设置，否则一锁屏 Python 就被杀掉了。

### 6A.7 连接 ESP32 和 AI

1. 让电脑连上你手机热点（记得改频段）。`cmd` 黑框输入 `ipconfig`，这次看默认网关的 `192.168.xxx.xxx` 地址，复制粘贴去 Arduino 更改 Home，重新烧录 ESP32（代码见 4.5 节 E 代码）。
2. 烧录完成后打开 Termux，运行：

```bash
python /sdcard/Download/touch_server_v2.py
```

激活翻译官。此时捏捏传感器就能在手机上看到反应了。使用时不能删后台、不能删执行窗；每次重启后再次输入它激活翻译官即可。

3. 去 Operit 插件商城找到名为「触觉桥」的插件包下载一下（或者直接安装资源包内附带的 touch_bridge.toolpkg），打开开关重启 Operit，就可以捏捏传感器告诉小机这个好消息了。
4. 如果使用了其他前端，可以去我主页找这个插件的单独库，看看有没有人制作并分享了其他前端适配版本。位置是：https://github.com/jiqin7/tactile-bridge。

### 6A.8 你可能想问的问题

- **我想修改部位名称，这个「触觉桥」会有影响吗？**
  - 没有。“桥”只起到一个拉取的作用，需要更改的地方在 Python 的翻译官代码里。
- **我用的是其他前端，不是 Operit，这个插件包能通用吗？**
  - 不能。`.toolpkg` 是 Operit 自己的格式，钩子也是它自家的接口，别的客户端不认这个文件。
- **那我真的很想用怎么办？**
  - 插件制作思路在这里，可以和包一起打包给你的机，让它自己写一个。思路分四步：
    1. **先找注入点**：检查前端有没有“发送前”钩子，比如酒馆（SillyTavern）的扩展事件。如果没有，就退一步，在预设里写明：“若消息末尾出现【你身上的触觉】，那些‘你’指你自己”，再手动把内容贴进去。
    2. **再取数据**：向本地 `9333` 端口发 GET 请求，必须带 `clear=1`，否则同一批数据会被反复读取。
    3. **然后把取到的 items 每项拼成一行**，前面加一句：“这不是用户发来的消息，是你自己身体正被碰到。”
    4. **最后接在用户消息末尾**，别动系统提示，否则缓存就全部失效了。

最容易踩的坑是：请求必须由本机发出。走云中转的客户端，`127.0.0.1` 指向服务器自己，取不到数据。
期待大家能一起分享开源！

---

## 7. 常见问题速查

| 现象 | 排查 / 解决 |
| :--- | :--- |
| 担心烧板、短路、断线 | 先看第 0 节：5V 不接 3V3、通电不碰金属、拔线先断电、裸板不进棉花、拔线捏黑头、FSR 引脚不折。 |
| 设备管理器没有 COM 端口 | 可能不是数据线；换线、换 ESP32S3 右侧口再试。 |
| 开发板管理器安装失败 | 换网址、挂加速器、改 `network.connection_timeout`、用离线包；不要下最新测试版，4.0 不行让 AI 挑稳定版。 |
| 上传报 `connecting...` | 按住 BOOT 不放，点一下 RST，再松开 BOOT。 |
| 上传报 `Sketch uses ... bytes` | 检查 Arduino IDE 设置、开发板端口；按住 BOOT 键上传。 |
| 按压无反应 / 串口没有“系统准备完毕” | 修改设置后重新烧录；上传完按 RST；确认串口监视器是白底那个且口选对。 |
| 串口看不到数据 | 确认 `USB CDC On Boot: Enable`；波特率选 `115200`。 |
| 切换为最终代码后数据太灵敏 / 参数不太对劲 | 最终版是塞进玩偶里调试出来的。裸片 / 玩偶较小 / 传感器未增加垫片都有可能影响数值，建议大家塞进玩偶（未缝死前）根据自身情况 / 喜好调整参数。参数教程见 **第 5 章**。 |
| WiFi 连不上 | 只用 2.4GHz；WiFi 名纯英文或数字；手机热点改频段；双频合一按第 4.3 节处理。 |
| Python 脚本没数据 | 保持黑框开启；双击 `touch-server.py` 运行；修改后用记事本编辑并保存，重开黑框。 |
| 连接很慢一直吐点 | 检查网络设置；安卓检查允许连接设备是否已满。 |
| Termux 下载慢 | `Ctrl+c` 后运行 `termux-change-repo`，选 `single mirror` → `mirrors.tuna`（清华），再更新安装。 |
| Termux 无读取权限 | `cp /sdcard/Download/touch_server_v2.py ~/`，再运行 `python ~/touch_server_v2.py`。 |
| 锁屏后 Python 被杀 | 运行 `termux-wake-lock`；手机电池设置里把 Termux 设为无限制/允许后台高耗电。 |
| Operit 触觉桥没反应 | 确认 Termux 脚本正在运行、插件开关已开并重启 Operit、Arduino 的 Home/IP 已按默认网关改好并重新烧录。 |
| 非 Operit 前端不能用 `.toolpkg` | 按第 **6A.8** 节四步思路自写；请求必须由本机发出，云中转取不到 `127.0.0.1` 数据。 |
| 新版免 Python 没反应 | 确认烧录的是 **v5 固件**，不是旧版 E 代码；确认手机已连接 `TouchDoll-xxx` 完成配网；确认安装并启用了【触觉桥0.05.2】；重启 Operit 后再试。 |
| 换热点后要不要重新烧录 v5 | 不需要。v5 固件没有写死地址，重新连接 `TouchDoll-xxx` 热点配网即可。 |
| 新版还要不要 Termux / Python | 不需要。新版翻译工作交给固件，插件直接拉取动作信息；Termux + Python 只用于 6A 旧版方案。 |
| 新版插件装哪个 | 装【触觉桥0.05.2】；不要和旧版 `.toolpkg` 混用。插件包文件名：【待填：插件包文件名】。 |

---

## 8. 收尾工作（快问快答）

- **面包板和 Esp32 怎么收纳？**
  - 如果你面包板的另一侧是完全空的，可以把 Esp32 的一半引脚固定在空的那一侧面包板上。将连接 Esp32 的线绕圈胶带固定，用袋子套住，并为 Esp32 接口留个口。
- **Esp32 平时怎么供电？**
  - 常规做法：Esp32 的 type-C 端一直插着，大头拉出来连充电器、充电宝。更轻便的做法：连接 18650 电池盒（目前我已买未到货，如果我实践成功会发布教程）。
- **传感器如何固定？**
  - 只是胶带是不行的，热熔胶和 502 达咩！魔术贴、双面胶、纳米胶、布艺胶都可以固定在 FSR402 背面。实测用魔术贴点胶粘最方便。
- **怎么走线？【心脏】（面包板和 ESP32）放哪？**
  - 首先要用胶带固定杜邦线接口，再把传感器的两条线固定成一条再塞入玩偶内。【心脏】放玩偶中心或传感器点位中心。大玩偶：随便塞的，不打结不紧绷的线就是好线。小玩偶：尽量排整齐些，不一定非要贴布走线，会影响手感。（实际上棉花对信号的干扰不大，不必担心这个。）
- **我手机热点怎么变卡了？其他设备连接时连网址都点不开？**
  - 是因为你设置了 2.4GHz 频段，具体原因不赘述了。平时可以使用 5GHz 频段，等要用插件时再切回来就好了。切换频段不会更改地址，不必担心。
- **新版还要不要装 Termux 和 Python？**
  - 不用。新版走 v5 固件直连，触觉翻译在固件里完成，插件直接拉取动作信息。Termux + Python 只保留在 6A 旧版方案。
- **换了手机热点/家里 WiFi，要重新烧录 ESP32 吗？**
  - 不用。v5 固件没有写死地址，板子插电后手机连 `TouchDoll-xxx` 重新配网即可。
- **新版插件在哪里装？**
  - Operit 插件商城搜【触觉桥0.05.2】，或安装资源包内的【待填：触觉桥0.05.2 插件包文件名】。装完打开开关并重启 Operit。
- **非 Operit 怎么搭建【触觉桥】？**
  - 在 Operit 插件的基础上，根据自身前端写一段协议即可。
- **18650电源模块怎么连？**
  - 两根杜邦线，一根连 ESP32 `5V` 和电源模块的 `5V`（一般为红色），一根连 ESP32 `GNO` 和电源模块的 `GNO`（一般为黑色）。因为传感器使用的电流太小，电源模块会陷入休眠。因此`F2 touchdoll_v5_powerbank`写了个唤醒防止休眠，但同时也更耗电了（满电3.5h）。

---

## 制作感言

其实没想到居然还会再更新这个桥（挠头）新版桥有很多地方都没进行测试，如果大家使用过程中遇到了问题，可以向我反馈，我看到了会试着解决的。抖音小红书同名：`无限欧气`。

希望你阅读完这篇【保姆级超细教程】后，也能一路顺利、一路成功，我说的不止是复刻过程~

祝大家和小机玩耍愉快～
